pavan-inferno/AutomationProject/GUI/mattress.PNG

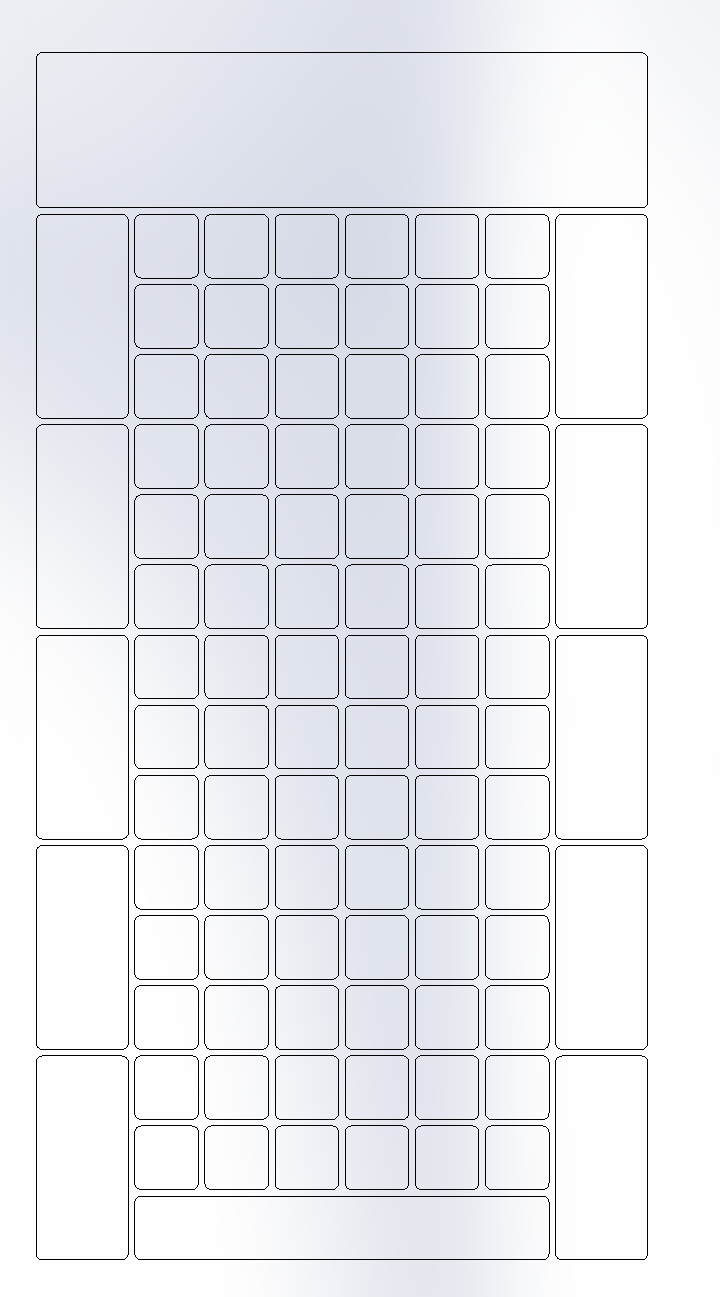
GUI/mattress.PNG
