pavan-inferno/AutomationProject/GUI/mattress_numbering.PNG

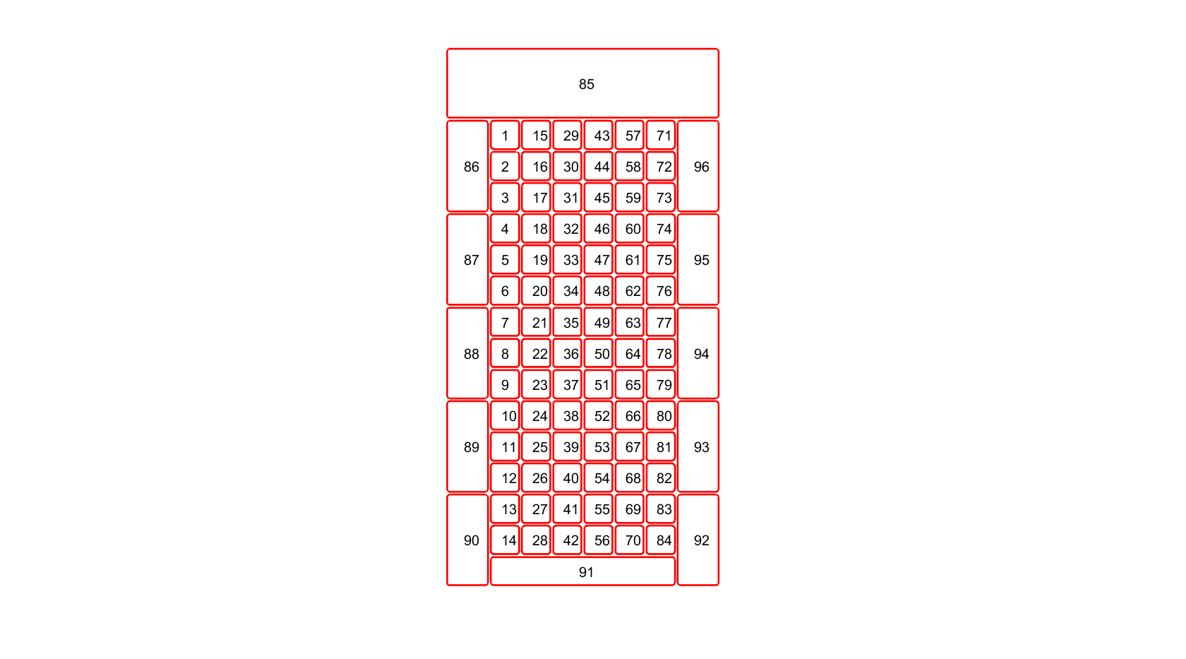
GUI/mattress_numbering.PNG
