pavan-inferno/AutomationProject/PCB/CPplacement.PNG

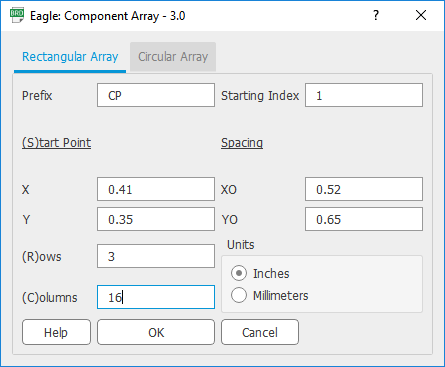
PCB/CPplacement.PNG
