pavan-inferno/AutomationProject/PCB/bed_prod.brd

## EAGLE design PCB/bed_prod.brd (2020-02-03)

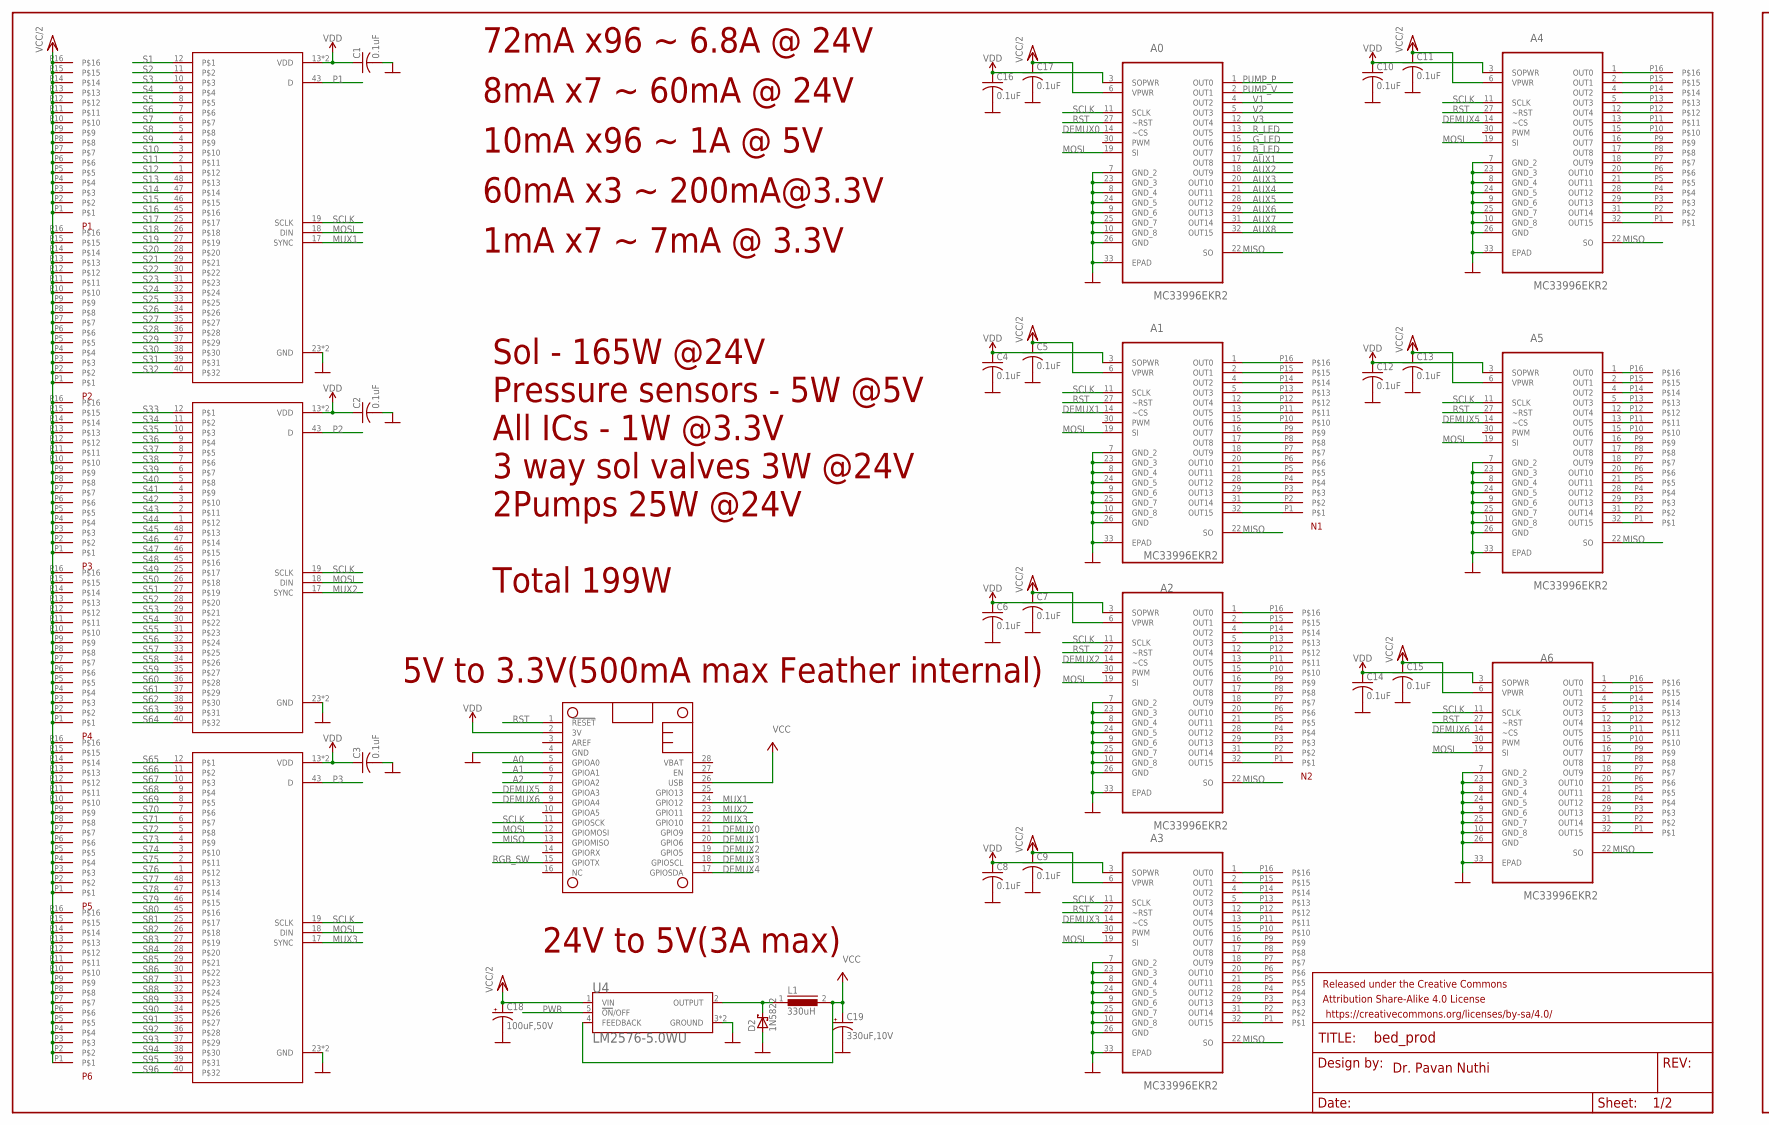
[picture p4: schematic bed_prod.sch, sheet 1, part in row 1, column 1]

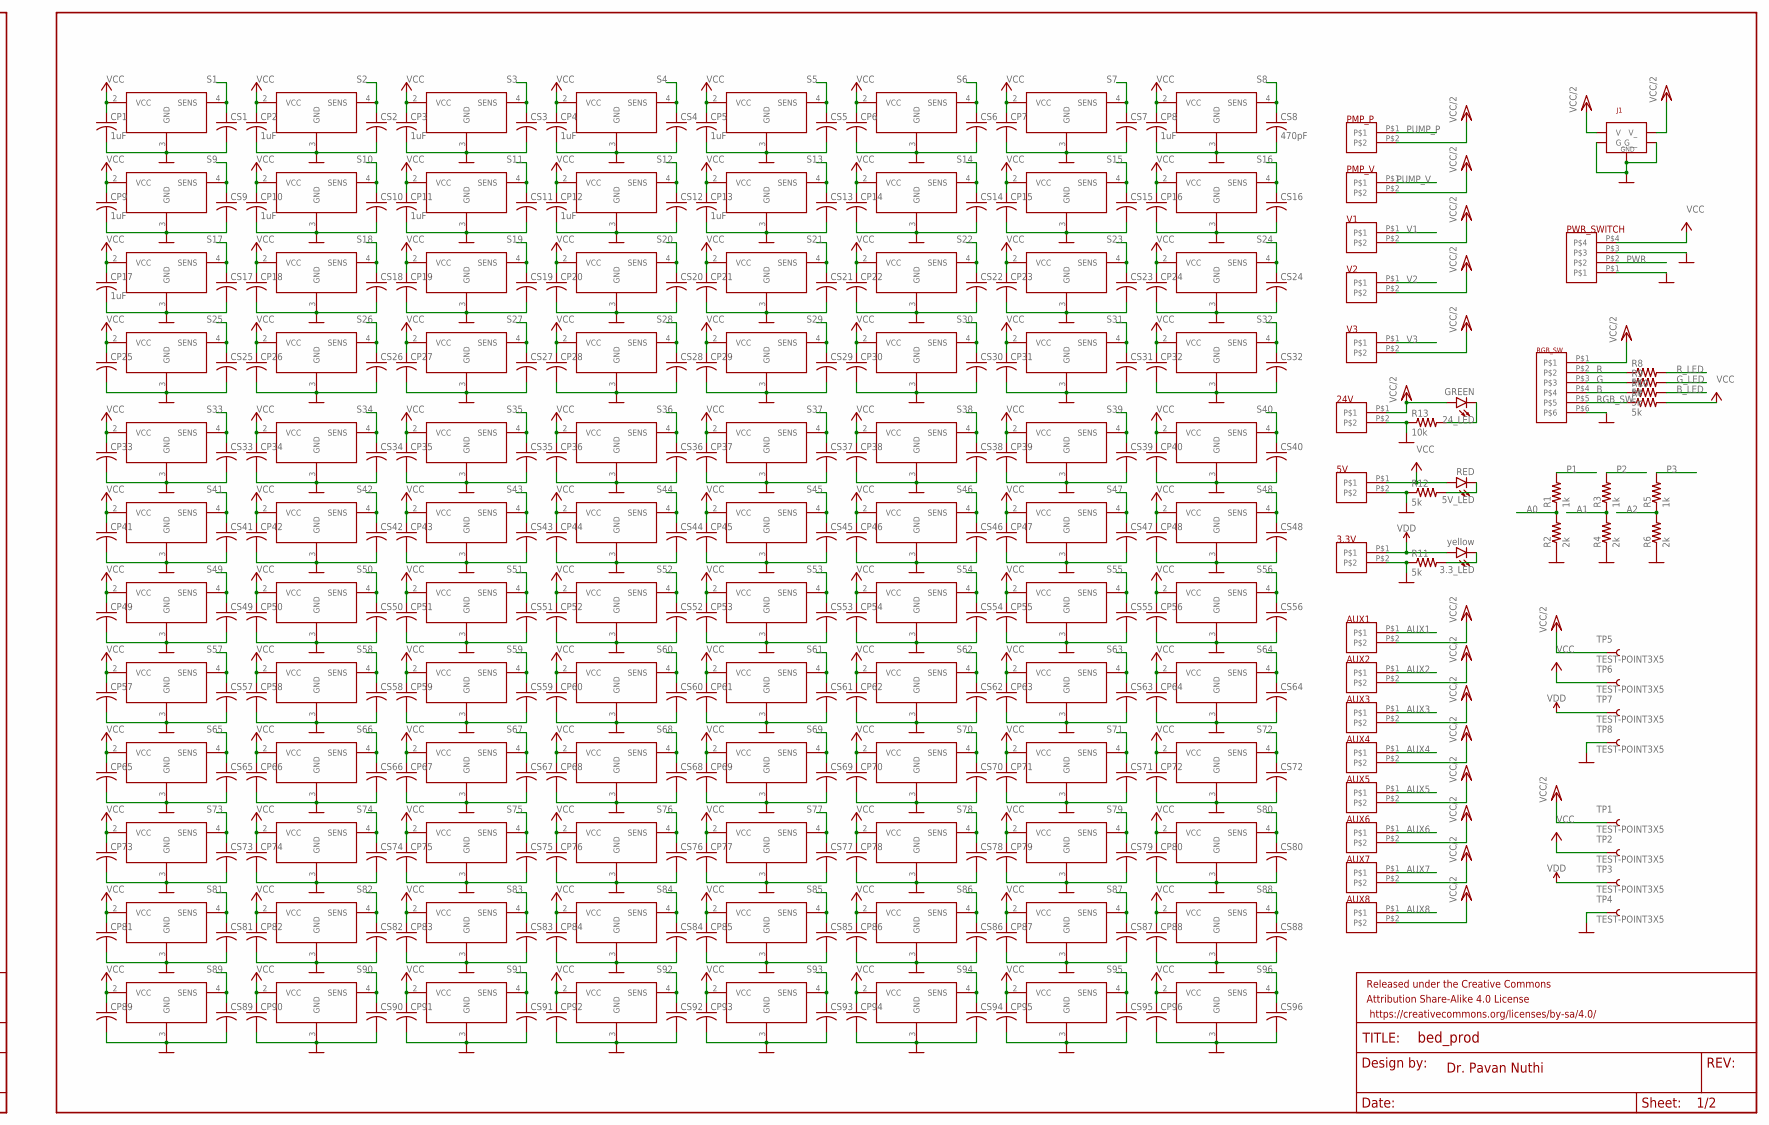
[picture p5: schematic bed_prod.sch, sheet 1, part in row 1, column 2]

Parts:
3.3V, 5V, 24V: 2CONN_2MM
3.3_LED: yellow; LED-1206
5V_LED: RED; LED-1206
24_LED: GREEN; LED-1206
A0, A1, A2, A3, A4, A5, A6: MC33996EKR2; SOIC65P1030X265-32N
AUX1, AUX2, AUX3, AUX4, AUX5, AUX6, AUX7, AUX8: 2CONN_2MM
C1, C2, C3, C4, C5, C6, C7, C8, C9, C10, C11, C12, C13, C14, C15, C16, C17: 0.1uF; C1206
C18: 100uF,50V; E3,5-8
C19: 330uF,10V; E3,5-8
CP1, CP2, CP3, CP4, CP5, CP8, CP9, CP10, CP11, CP12, CP13, CP17: 1uF; C1206
CP6, CP7, CP14, CP15, CP16, CP18, CP19, CP20, CP21, CP22, CP23, CP24, CP25, CP26, CP27, CP28, CP29, CP30, CP31, CP32, CP33, CP34, CP35, CP36, CP37, CP38, CP39, CP40, CP41, CP42, CP43, CP44, CP45, CP46, CP47, CP48, CP49, CP50, CP51, CP52, CP53, CP54, CP55, CP56, CP57, CP58, CP59, CP60, CP61, CP62, CP63, CP64, CP65, CP66, CP67, CP68, CP69, CP70, CP71, CP72, CP73, CP74, CP75, CP76, CP77, CP78, CP79, CP80, CP81, CP82, CP83, CP84, CP85, CP86, CP87, CP88, CP89, CP90, CP91, CP92, CP93, CP94, CP95, CP96: C-USC1206; C1206
CS1, CS2, CS3, CS4, CS5, CS6, CS7, CS9, CS10, CS11, CS12, CS13, CS14, CS15, CS16, CS17, CS18, CS19, CS20, CS21, CS22, CS23, CS24, CS25, CS26, CS27, CS28, CS29, CS30, CS31, CS32, CS33, CS34, CS35, CS36, CS37, CS38, CS39, CS40, CS41, CS42, CS43, CS44, CS45, CS46, CS47, CS48, CS49, CS50, CS51, CS52, CS53, CS54, CS55, CS56, CS57, CS58, CS59, CS60, CS61, CS62, CS63, CS64, CS65, CS66, CS67, CS68, CS69, CS70, CS71, CS72, CS73, CS74, CS75, CS76, CS77, CS78, CS79, CS80, CS81, CS82, CS83, CS84, CS85, CS86, CS87, CS88, CS89, CS90, CS91, CS92, CS93, CS94, CS95, CS96: C-USC1206; C1206
CS8: 470pF; C1206
D2: 1N5822; DO201T15
FRAME1, FRAME2: FRAME-LEDGER; CREATIVE_COMMONS
J1: KPJX-4S-S; KYCON-KPXJ-4S
L1: 330uH; DR127
MS1: FEATHERWING_NODIM; FEATHERWING_DIM
N1, N2, N3, N4, N5, N6: 16CONN_2MM
P1, P2, P3, P4, P5, P6: 16CONN_2MM
PMP_P: 2CONN_2MM
PMP_V: 2CONN_2MM
PWR_SWITCH: 4CONN_2MM
R1, R3, R5: 1k; R1206
R2, R4, R6: 2k; R1206
R7, R9, R10, R11, R12: 5k; R1206W
R8: 5K; R1206W
R13: 10k; R1206W
RGB_SW: 6CONN_2MM
SENS1, SENS2, SENS3, SENS4, SENS5, SENS6, SENS7, SENS8, SENS9, SENS10, SENS11, SENS12, SENS13, SENS14, SENS15, SENS16, SENS17, SENS18, SENS19, SENS20, SENS21, SENS22, SENS23, SENS24, SENS25, SENS26, SENS27, SENS28, SENS29, SENS30, SENS31, SENS32, SENS33, SENS34, SENS35, SENS36, SENS37, SENS38, SENS39, SENS40, SENS41, SENS42, SENS43, SENS44, SENS45, SENS46, SENS47, SENS48, SENS49, SENS50, SENS51, SENS52, SENS53, SENS54, SENS55, SENS56, SENS57, SENS58, SENS59, SENS60, SENS61, SENS62, SENS63, SENS64, SENS65, SENS66, SENS67, SENS68, SENS69, SENS70, SENS71, SENS72, SENS73, SENS74, SENS75, SENS76, SENS77, SENS78, SENS79, SENS80, SENS81, SENS82, SENS83, SENS84, SENS85, SENS86, SENS87, SENS88, SENS89, SENS90, SENS91, SENS92, SENS93, SENS94, SENS95, SENS96: MPX5100; 98ASB17759C
TP1, TP2, TP3, TP4, TP5, TP6, TP7, TP8: TEST-POINT3X5; PAD.03X.05
U1, U2, U3: ADG731; QFP50P900X900X160-49N
U4: LM2576-5.0WU; DPAK6P170_1524X459L254X81N
V1, V2, V3: 2CONN_2MM

Connections:
A0: MS1.5 (GPIOA0), R1.1, R2.2
A1: MS1.6 (GPIOA1), R3.1, R4.2
A2: MS1.7 (GPIOA2), R5.1, R6.2
AUX1: A0.17 (OUT8), AUX1.P$1
AUX2: A0.18 (OUT9), AUX2.P$1
AUX3: A0.20 (OUT10), AUX3.P$1
AUX4: A0.21 (OUT11), AUX4.P$1
AUX5: A0.28 (OUT12), AUX5.P$1
AUX6: A0.29 (OUT13), AUX6.P$1
AUX7: A0.31 (OUT14), AUX7.P$1
AUX8: A0.32 (OUT15), AUX8.P$1
B: R10.1, RGB_SW.P$4
B_LED: A0.16 (OUT7), R10.2
DEMUX0: A0.14 (~CS), MS1.21 (GPIO9)
DEMUX1: A1.14 (~CS), MS1.20 (GPIO6)
DEMUX2: A2.14 (~CS), MS1.19 (GPIO5)
DEMUX3: A3.14 (~CS), MS1.18 (GPIOSCL)
DEMUX4: A4.14 (~CS), MS1.17 (GPIOSDA)
DEMUX5: A5.14 (~CS), MS1.8 (GPIOA3)
DEMUX6: A6.14 (~CS), MS1.9 (GPIOA4)
G: R9.1, RGB_SW.P$3
GND: 3.3V.P$2, 5V.P$2, 24V.P$2, A0.7 (GND_2), A0.8 (GND_4), A0.9 (GND_6), A0.10 (GND_8), A0.23 (GND_3), A0.24 (GND_5), A0.25 (GND_7), A0.26 (GND), A0.33 (EPAD), A1.7 (GND_2), A1.8 (GND_4), A1.9 (GND_6), A1.10 (GND_8), A1.23 (GND_3), A1.24 (GND_5), A1.25 (GND_7), A1.26 (GND), A1.33 (EPAD), A2.7 (GND_2), A2.8 (GND_4), A2.9 (GND_6), A2.10 (GND_8), A2.23 (GND_3), A2.24 (GND_5), A2.25 (GND_7), A2.26 (GND), A2.33 (EPAD), A3.7 (GND_2), A3.8 (GND_4), A3.9 (GND_6), A3.10 (GND_8), A3.23 (GND_3), A3.24 (GND_5), A3.25 (GND_7), A3.26 (GND), A3.33 (EPAD), A4.7 (GND_2), A4.8 (GND_4), A4.9 (GND_6), A4.10 (GND_8), A4.23 (GND_3), A4.24 (GND_5), A4.25 (GND_7), A4.26 (GND), A4.33 (EPAD), A5.7 (GND_2), A5.8 (GND_4), A5.9 (GND_6), A5.10 (GND_8), A5.23 (GND_3), A5.24 (GND_5), A5.25 (GND_7), A5.26 (GND), A5.33 (EPAD), A6.7 (GND_2), A6.8 (GND_4), A6.9 (GND_6), A6.10 (GND_8), A6.23 (GND_3), A6.24 (GND_5), A6.25 (GND_7), A6.26 (GND), A6.33 (EPAD), C1.2, C2.2, C3.2, C4.2, C5.2, C6.2, C7.2, C8.2, C9.2, C10.2, C11.2, C12.2, C13.2, C14.2, C15.2, C16.2, C17.2, C18.-, C19.-, CP1.2, CP2.2, CP3.2, CP4.2, CP5.2, CP6.2, CP7.2, CP8.2, CP9.2, CP10.2, CP11.2, CP12.2, CP13.2, CP14.2, CP15.2, CP16.2, CP17.2, CP18.2, CP19.2, CP20.2, CP21.2, CP22.2, CP23.2, CP24.2, CP25.2, CP26.2, CP27.2, CP28.2, CP29.2, CP30.2, CP31.2, CP32.2, CP33.2, CP34.2, CP35.2, CP36.2, CP37.2, CP38.2, CP39.2, CP40.2, CP41.2, CP42.2, CP43.2, CP44.2, CP45.2, CP46.2, CP47.2, CP48.2, CP49.2, CP50.2, CP51.2, CP52.2, CP53.2, CP54.2, CP55.2, CP56.2, CP57.2, CP58.2, CP59.2, CP60.2, CP61.2, CP62.2, CP63.2, CP64.2, CP65.2, CP66.2, CP67.2, CP68.2, CP69.2, CP70.2, CP71.2, CP72.2, CP73.2, CP74.2, CP75.2, CP76.2, CP77.2, CP78.2, CP79.2, CP80.2, CP81.2, CP82.2, CP83.2, CP84.2, CP85.2, CP86.2, CP87.2, CP88.2, CP89.2, CP90.2, CP91.2, CP92.2, CP93.2, CP94.2, CP95.2, CP96.2, CS1.2, CS2.2, CS3.2, CS4.2, CS5.2, CS6.2, CS7.2, CS8.2, CS9.2, CS10.2, CS11.2, CS12.2, CS13.2, CS14.2, CS15.2, CS16.2, CS17.2, CS18.2, CS19.2, CS20.2, CS21.2, CS22.2, CS23.2, CS24.2, CS25.2, CS26.2, CS27.2, CS28.2, CS29.2, CS30.2, CS31.2, CS32.2, CS33.2, CS34.2, CS35.2, CS36.2, CS37.2, CS38.2, CS39.2, CS40.2, CS41.2, CS42.2, CS43.2, CS44.2, CS45.2, CS46.2, CS47.2, CS48.2, CS49.2, CS50.2, CS51.2, CS52.2, CS53.2, CS54.2, CS55.2, CS56.2, CS57.2, CS58.2, CS59.2, CS60.2, CS61.2, CS62.2, CS63.2, CS64.2, CS65.2, CS66.2, CS67.2, CS68.2, CS69.2, CS70.2, CS71.2, CS72.2, CS73.2, CS74.2, CS75.2, CS76.2, CS77.2, CS78.2, CS79.2, CS80.2, CS81.2, CS82.2, CS83.2, CS84.2, CS85.2, CS86.2, CS87.2, CS88.2, CS89.2, CS90.2, CS91.2, CS92.2, CS93.2, CS94.2, CS95.2, CS96.2, D2.A, J1.GND (G), J1.GND_ (G_), J1.GND__ (G__), MS1.4 (GND), PWR_SWITCH.P$1, PWR_SWITCH.P$3, R2.1, R4.1, R6.1, R11.1, R12.1, R13.1, RGB_SW.P$6, SENS1.3 (GND), SENS2.3 (GND), SENS3.3 (GND), SENS4.3 (GND), SENS5.3 (GND), SENS6.3 (GND), SENS7.3 (GND), SENS8.3 (GND), SENS9.3 (GND), SENS10.3 (GND), SENS11.3 (GND), SENS12.3 (GND), SENS13.3 (GND), SENS14.3 (GND), SENS15.3 (GND), SENS16.3 (GND), SENS17.3 (GND), SENS18.3 (GND), SENS19.3 (GND), SENS20.3 (GND), SENS21.3 (GND), SENS22.3 (GND), SENS23.3 (GND), SENS24.3 (GND), SENS25.3 (GND), SENS26.3 (GND), SENS27.3 (GND), SENS28.3 (GND), SENS29.3 (GND), SENS30.3 (GND), SENS31.3 (GND), SENS32.3 (GND), SENS33.3 (GND), SENS34.3 (GND), SENS35.3 (GND), SENS36.3 (GND), SENS37.3 (GND), SENS38.3 (GND), SENS39.3 (GND), SENS40.3 (GND), SENS41.3 (GND), SENS42.3 (GND), SENS43.3 (GND), SENS44.3 (GND), SENS45.3 (GND), SENS46.3 (GND), SENS47.3 (GND), SENS48.3 (GND), SENS49.3 (GND), SENS50.3 (GND), SENS51.3 (GND), SENS52.3 (GND), SENS53.3 (GND), SENS54.3 (GND), SENS55.3 (GND), SENS56.3 (GND), SENS57.3 (GND), SENS58.3 (GND), SENS59.3 (GND), SENS60.3 (GND), SENS61.3 (GND), SENS62.3 (GND), SENS63.3 (GND), SENS64.3 (GND), SENS65.3 (GND), SENS66.3 (GND), SENS67.3 (GND), SENS68.3 (GND), SENS69.3 (GND), SENS70.3 (GND), SENS71.3 (GND), SENS72.3 (GND), SENS73.3 (GND), SENS74.3 (GND), SENS75.3 (GND), SENS76.3 (GND), SENS77.3 (GND), SENS78.3 (GND), SENS79.3 (GND), SENS80.3 (GND), SENS81.3 (GND), SENS82.3 (GND), SENS83.3 (GND), SENS84.3 (GND), SENS85.3 (GND), SENS86.3 (GND), SENS87.3 (GND), SENS88.3 (GND), SENS89.3 (GND), SENS90.3 (GND), SENS91.3 (GND), SENS92.3 (GND), SENS93.3 (GND), SENS94.3 (GND), SENS95.3 (GND), SENS96.3 (GND), TP4.P$1, TP8.P$1, U1.23 (GND), U1.24 (GND), U2.23 (GND), U2.24 (GND), U3.23 (GND), U3.24 (GND), U4.3 (GROUND), U4.6 (GROUND)
G_LED: A0.15 (OUT6), R9.2
MISO: A0.22 (SO), A1.22 (SO), A2.22 (SO), A3.22 (SO), A4.22 (SO), A5.22 (SO), A6.22 (SO), MS1.13 (GPIOMISO)
MOSI: A0.19 (SI), A1.19 (SI), A2.19 (SI), A3.19 (SI), A4.19 (SI), A5.19 (SI), A6.19 (SI), MS1.12 (GPIOMOSI), U1.18 (DIN), U2.18 (DIN), U3.18 (DIN)
MUX1: MS1.24 (GPIO12), U1.17 (SYNC)
MUX2: MS1.23 (GPIO11), U2.17 (SYNC)
MUX3: MS1.22 (GPIO10), U3.17 (SYNC)
unnamed: D2.C, L1.1, U4.2 (OUTPUT)
unnamed: A5.1 (OUT0), N5.P16
unnamed: A5.2 (OUT1), N5.P15
unnamed: A5.4 (OUT2), N5.P14
unnamed: A5.5 (OUT3), N5.P13
unnamed: A5.12 (OUT4), N5.P12
unnamed: A5.13 (OUT5), N5.P11
unnamed: A5.15 (OUT6), N5.P10
unnamed: A5.16 (OUT7), N5.P9
unnamed: A5.17 (OUT8), N5.P8
unnamed: A5.18 (OUT9), N5.P7
unnamed: A5.20 (OUT10), N5.P6
unnamed: A5.21 (OUT11), N5.P5
unnamed: A5.28 (OUT12), N5.P4
unnamed: A5.29 (OUT13), N5.P3
unnamed: A5.31 (OUT14), N5.P2
unnamed: A5.32 (OUT15), N5.P1
unnamed: A6.1 (OUT0), N6.P16
unnamed: A6.2 (OUT1), N6.P15
unnamed: A6.4 (OUT2), N6.P14
unnamed: A6.5 (OUT3), N6.P13
unnamed: A6.12 (OUT4), N6.P12
unnamed: A6.13 (OUT5), N6.P11
unnamed: A6.15 (OUT6), N6.P10
unnamed: A6.16 (OUT7), N6.P9
unnamed: A6.17 (OUT8), N6.P8
unnamed: A6.18 (OUT9), N6.P7
unnamed: A6.20 (OUT10), N6.P6
unnamed: A6.21 (OUT11), N6.P5
unnamed: A6.28 (OUT12), N6.P4
unnamed: A6.29 (OUT13), N6.P3
unnamed: A6.31 (OUT14), N6.P2
unnamed: A6.32 (OUT15), N6.P1
unnamed: A4.1 (OUT0), N4.P16
unnamed: A4.2 (OUT1), N4.P15
unnamed: A4.4 (OUT2), N4.P14
unnamed: A4.5 (OUT3), N4.P13
unnamed: A4.12 (OUT4), N4.P12
unnamed: A4.13 (OUT5), N4.P11
unnamed: A4.15 (OUT6), N4.P10
unnamed: A4.16 (OUT7), N4.P9
unnamed: A4.17 (OUT8), N4.P8
unnamed: A4.18 (OUT9), N4.P7
unnamed: A4.20 (OUT10), N4.P6
unnamed: A4.21 (OUT11), N4.P5
unnamed: A4.28 (OUT12), N4.P4
unnamed: A4.29 (OUT13), N4.P3
unnamed: A4.31 (OUT14), N4.P2
unnamed: A4.32 (OUT15), N4.P1
unnamed: A3.1 (OUT0), N3.P16
unnamed: A3.2 (OUT1), N3.P15
unnamed: A3.4 (OUT2), N3.P14
unnamed: A3.5 (OUT3), N3.P13
unnamed: A3.12 (OUT4), N3.P12
unnamed: A3.13 (OUT5), N3.P11
unnamed: A3.15 (OUT6), N3.P10
unnamed: A3.16 (OUT7), N3.P9
unnamed: A3.17 (OUT8), N3.P8
unnamed: A3.18 (OUT9), N3.P7
unnamed: A3.20 (OUT10), N3.P6
unnamed: A3.21 (OUT11), N3.P5
unnamed: A3.28 (OUT12), N3.P4
unnamed: A3.29 (OUT13), N3.P3
unnamed: A3.31 (OUT14), N3.P2
unnamed: A1.1 (OUT0), N1.P16
unnamed: A1.2 (OUT1), N1.P15
unnamed: A1.4 (OUT2), N1.P14
unnamed: A1.5 (OUT3), N1.P13
unnamed: A1.12 (OUT4), N1.P12
unnamed: A1.13 (OUT5), N1.P11
unnamed: A1.15 (OUT6), N1.P10
unnamed: A1.16 (OUT7), N1.P9
unnamed: A1.17 (OUT8), N1.P8
unnamed: A1.18 (OUT9), N1.P7
unnamed: A1.20 (OUT10), N1.P6
unnamed: A1.21 (OUT11), N1.P5
unnamed: A1.28 (OUT12), N1.P4
unnamed: A1.29 (OUT13), N1.P3
unnamed: A1.31 (OUT14), N1.P2
unnamed: A1.32 (OUT15), N1.P1
unnamed: A2.1 (OUT0), N2.P16
unnamed: A2.2 (OUT1), N2.P15
unnamed: A2.4 (OUT2), N2.P14
unnamed: A2.5 (OUT3), N2.P13
unnamed: A2.12 (OUT4), N2.P12
unnamed: A2.13 (OUT5), N2.P11
unnamed: A2.15 (OUT6), N2.P10
unnamed: A2.16 (OUT7), N2.P9
unnamed: A2.17 (OUT8), N2.P8
unnamed: A2.18 (OUT9), N2.P7
unnamed: A2.20 (OUT10), N2.P6
unnamed: A2.21 (OUT11), N2.P5
unnamed: A2.28 (OUT12), N2.P4
unnamed: A2.29 (OUT13), N2.P3
unnamed: A2.31 (OUT14), N2.P2
unnamed: A2.32 (OUT15), N2.P1
unnamed: 3.3_LED.C, R11.2
unnamed: 24_LED.C, R13.2
unnamed: 5V_LED.C, R12.2
unnamed: A3.32 (OUT15), N3.P1
P1: R1.2, U1.43 (D)
P2: R3.2, U2.43 (D)
P3: R5.2, U3.43 (D)
PUMP_P: A0.1 (OUT0), PMP_P.P$1
PUMP_V: A0.2 (OUT1), PMP_V.P$1
PWR: PWR_SWITCH.P$2, U4.5 (!ON!/OFF)
R: R8.1, RGB_SW.P$2
RGB_SW: MS1.15 (GPIOTX), R7.1, RGB_SW.P$5
RST: A0.27 (~RST), A1.27 (~RST), A2.27 (~RST), A3.27 (~RST), A4.27 (~RST), A5.27 (~RST), A6.27 (~RST), MS1.1 (!RESET)
R_LED: A0.13 (OUT5), R8.2
S1: CS1.1, SENS1.4 (SENS), U1.12
S2: CS2.1, SENS2.4 (SENS), U1.11
S3: CS3.1, SENS3.4 (SENS), U1.10
S4: CS4.1, SENS4.4 (SENS), U1.9
S5: CS5.1, SENS5.4 (SENS), U1.8
S6: CS6.1, SENS6.4 (SENS), U1.7
S7: CS7.1, SENS7.4 (SENS), U1.6
S8: CS8.1, SENS8.4 (SENS), U1.5
S9: CS9.1, SENS9.4 (SENS), U1.4
S10: CS10.1, SENS10.4 (SENS), U1.3
S11: CS11.1, SENS11.4 (SENS), U1.2
S12: CS12.1, SENS12.4 (SENS), U1.1
S13: CS13.1, SENS13.4 (SENS), U1.48
S14: CS14.1, SENS14.4 (SENS), U1.47
S15: CS15.1, SENS15.4 (SENS), U1.46
S16: CS16.1, SENS16.4 (SENS), U1.45
S17: CS17.1, SENS17.4 (SENS), U1.25
S18: CS18.1, SENS18.4 (SENS), U1.26
S19: CS19.1, SENS19.4 (SENS), U1.27
S20: CS20.1, SENS20.4 (SENS), U1.28
S21: CS21.1, SENS21.4 (SENS), U1.29
S22: CS22.1, SENS22.4 (SENS), U1.30
S23: CS23.1, SENS23.4 (SENS), U1.31
S24: CS24.1, SENS24.4 (SENS), U1.32
S25: CS25.1, SENS25.4 (SENS), U1.33
S26: CS26.1, SENS26.4 (SENS), U1.34
S27: CS27.1, SENS27.4 (SENS), U1.35
S28: CS28.1, SENS28.4 (SENS), U1.36
S29: CS29.1, SENS29.4 (SENS), U1.37
S30: CS30.1, SENS30.4 (SENS), U1.38
S31: CS31.1, SENS31.4 (SENS), U1.39
S32: CS32.1, SENS32.4 (SENS), U1.40
S33: CS33.1, SENS33.4 (SENS), U2.12
S34: CS34.1, SENS34.4 (SENS), U2.11
S35: CS35.1, SENS35.4 (SENS), U2.10
S36: CS36.1, SENS36.4 (SENS), U2.9
S37: CS37.1, SENS37.4 (SENS), U2.8
S38: CS38.1, SENS38.4 (SENS), U2.7
S39: CS39.1, SENS39.4 (SENS), U2.6
S40: CS40.1, SENS40.4 (SENS), U2.5
S41: CS41.1, SENS41.4 (SENS), U2.4
S42: CS42.1, SENS42.4 (SENS), U2.3
S43: CS43.1, SENS43.4 (SENS), U2.2
S44: CS44.1, SENS44.4 (SENS), U2.1
S45: CS45.1, SENS45.4 (SENS), U2.48
S46: CS46.1, SENS46.4 (SENS), U2.47
S47: CS47.1, SENS47.4 (SENS), U2.46
S48: CS48.1, SENS48.4 (SENS), U2.45
S49: CS49.1, SENS49.4 (SENS), U2.25
S50: CS50.1, SENS50.4 (SENS), U2.26
S51: CS51.1, SENS51.4 (SENS), U2.27
S52: CS52.1, SENS52.4 (SENS), U2.28
S53: CS53.1, SENS53.4 (SENS), U2.29
S54: CS54.1, SENS54.4 (SENS), U2.30
S55: CS55.1, SENS55.4 (SENS), U2.31
S56: CS56.1, SENS56.4 (SENS), U2.32
S57: CS57.1, SENS57.4 (SENS), U2.33
S58: CS58.1, SENS58.4 (SENS), U2.34
S59: CS59.1, SENS59.4 (SENS), U2.35
S60: CS60.1, SENS60.4 (SENS), U2.36
S61: CS61.1, SENS61.4 (SENS), U2.37
S62: CS62.1, SENS62.4 (SENS), U2.38
S63: CS63.1, SENS63.4 (SENS), U2.39
S64: CS64.1, SENS64.4 (SENS), U2.40
S65: CS65.1, SENS65.4 (SENS), U3.12
S66: CS66.1, SENS66.4 (SENS), U3.11
S67: CS67.1, SENS67.4 (SENS), U3.10
S68: CS68.1, SENS68.4 (SENS), U3.9
S69: CS69.1, SENS69.4 (SENS), U3.8
S70: CS70.1, SENS70.4 (SENS), U3.7
S71: CS71.1, SENS71.4 (SENS), U3.6
S72: CS72.1, SENS72.4 (SENS), U3.5
S73: CS73.1, SENS73.4 (SENS), U3.4
S74: CS74.1, SENS74.4 (SENS), U3.3
S75: CS75.1, SENS75.4 (SENS), U3.2
S76: CS76.1, SENS76.4 (SENS), U3.1
S77: CS77.1, SENS77.4 (SENS), U3.48
S78: CS78.1, SENS78.4 (SENS), U3.47
S79: CS79.1, SENS79.4 (SENS), U3.46
S80: CS80.1, SENS80.4 (SENS), U3.45
S81: CS81.1, SENS81.4 (SENS), U3.25
S82: CS82.1, SENS82.4 (SENS), U3.26
S83: CS83.1, SENS83.4 (SENS), U3.27
S84: CS84.1, SENS84.4 (SENS), U3.28
S85: CS85.1, SENS85.4 (SENS), U3.29
S86: CS86.1, SENS86.4 (SENS), U3.30
S87: CS87.1, SENS87.4 (SENS), U3.31
S88: CS88.1, SENS88.4 (SENS), U3.32
S89: CS89.1, SENS89.4 (SENS), U3.33
S90: CS90.1, SENS90.4 (SENS), U3.34
S91: CS91.1, SENS91.4 (SENS), U3.35
S92: CS92.1, SENS92.4 (SENS), U3.36
S93: CS93.1, SENS93.4 (SENS), U3.37
S94: CS94.1, SENS94.4 (SENS), U3.38
S95: CS95.1, SENS95.4 (SENS), U3.39
S96: CS96.1, SENS96.4 (SENS), U3.40
SCLK: A0.11 (SCLK), A1.11 (SCLK), A2.11 (SCLK), A3.11 (SCLK), A4.11 (SCLK), A5.11 (SCLK), A6.11 (SCLK), MS1.11 (GPIOSCK), U1.19 (SCLK), U2.19 (SCLK), U3.19 (SCLK)
V1: A0.4 (OUT2), V1.P$1
V2: A0.5 (OUT3), V2.P$1
V3: A0.12 (OUT4), V3.P$1
VCC: 5V.P$1, 5V_LED.A, C19.+, CP1.1, CP2.1, CP3.1, CP4.1, CP5.1, CP6.1, CP7.1, CP8.1, CP9.1, CP10.1, CP11.1, CP12.1, CP13.1, CP14.1, CP15.1, CP16.1, CP17.1, CP18.1, CP19.1, CP20.1, CP21.1, CP22.1, CP23.1, CP24.1, CP25.1, CP26.1, CP27.1, CP28.1, CP29.1, CP30.1, CP31.1, CP32.1, CP33.1, CP34.1, CP35.1, CP36.1, CP37.1, CP38.1, CP39.1, CP40.1, CP41.1, CP42.1, CP43.1, CP44.1, CP45.1, CP46.1, CP47.1, CP48.1, CP49.1, CP50.1, CP51.1, CP52.1, CP53.1, CP54.1, CP55.1, CP56.1, CP57.1, CP58.1, CP59.1, CP60.1, CP61.1, CP62.1, CP63.1, CP64.1, CP65.1, CP66.1, CP67.1, CP68.1, CP69.1, CP70.1, CP71.1, CP72.1, CP73.1, CP74.1, CP75.1, CP76.1, CP77.1, CP78.1, CP79.1, CP80.1, CP81.1, CP82.1, CP83.1, CP84.1, CP85.1, CP86.1, CP87.1, CP88.1, CP89.1, CP90.1, CP91.1, CP92.1, CP93.1, CP94.1, CP95.1, CP96.1, L1.2, MS1.26 (USB), PWR_SWITCH.P$4, R7.2, SENS1.2 (VCC), SENS2.2 (VCC), SENS3.2 (VCC), SENS4.2 (VCC), SENS5.2 (VCC), SENS6.2 (VCC), SENS7.2 (VCC), SENS8.2 (VCC), SENS9.2 (VCC), SENS10.2 (VCC), SENS11.2 (VCC), SENS12.2 (VCC), SENS13.2 (VCC), SENS14.2 (VCC), SENS15.2 (VCC), SENS16.2 (VCC), SENS17.2 (VCC), SENS18.2 (VCC), SENS19.2 (VCC), SENS20.2 (VCC), SENS21.2 (VCC), SENS22.2 (VCC), SENS23.2 (VCC), SENS24.2 (VCC), SENS25.2 (VCC), SENS26.2 (VCC), SENS27.2 (VCC), SENS28.2 (VCC), SENS29.2 (VCC), SENS30.2 (VCC), SENS31.2 (VCC), SENS32.2 (VCC), SENS33.2 (VCC), SENS34.2 (VCC), SENS35.2 (VCC), SENS36.2 (VCC), SENS37.2 (VCC), SENS38.2 (VCC), SENS39.2 (VCC), SENS40.2 (VCC), SENS41.2 (VCC), SENS42.2 (VCC), SENS43.2 (VCC), SENS44.2 (VCC), SENS45.2 (VCC), SENS46.2 (VCC), SENS47.2 (VCC), SENS48.2 (VCC), SENS49.2 (VCC), SENS50.2 (VCC), SENS51.2 (VCC), SENS52.2 (VCC), SENS53.2 (VCC), SENS54.2 (VCC), SENS55.2 (VCC), SENS56.2 (VCC), SENS57.2 (VCC), SENS58.2 (VCC), SENS59.2 (VCC), SENS60.2 (VCC), SENS61.2 (VCC), SENS62.2 (VCC), SENS63.2 (VCC), SENS64.2 (VCC), SENS65.2 (VCC), SENS66.2 (VCC), SENS67.2 (VCC), SENS68.2 (VCC), SENS69.2 (VCC), SENS70.2 (VCC), SENS71.2 (VCC), SENS72.2 (VCC), SENS73.2 (VCC), SENS74.2 (VCC), SENS75.2 (VCC), SENS76.2 (VCC), SENS77.2 (VCC), SENS78.2 (VCC), SENS79.2 (VCC), SENS80.2 (VCC), SENS81.2 (VCC), SENS82.2 (VCC), SENS83.2 (VCC), SENS84.2 (VCC), SENS85.2 (VCC), SENS86.2 (VCC), SENS87.2 (VCC), SENS88.2 (VCC), SENS89.2 (VCC), SENS90.2 (VCC), SENS91.2 (VCC), SENS92.2 (VCC), SENS93.2 (VCC), SENS94.2 (VCC), SENS95.2 (VCC), SENS96.2 (VCC), TP2.P$1, TP6.P$1, U4.4 (FEEDBACK)
VCC/2: 24V.P$1, 24_LED.A, A0.6 (VPWR), A1.6 (VPWR), A2.6 (VPWR), A3.6 (VPWR), A4.6 (VPWR), A5.6 (VPWR), A6.6 (VPWR), AUX1.P$2, AUX2.P$2, AUX3.P$2, AUX4.P$2, AUX5.P$2, AUX6.P$2, AUX7.P$2, AUX8.P$2, C5.1, C7.1, C9.1, C11.1, C13.1, C15.1, C17.1, C18.+, J1.V+ (V), J1.V++ (V_), P1.P1, P1.P2, P1.P3, P1.P4, P1.P5, P1.P6, P1.P7, P1.P8, P1.P9, P1.P10, P1.P11, P1.P12, P1.P13, P1.P14, P1.P15, P1.P16, P2.P1, P2.P2, P2.P3, P2.P4, P2.P5, P2.P6, P2.P7, P2.P8, P2.P9, P2.P10, P2.P11, P2.P12, P2.P13, P2.P14, P2.P15, P2.P16, P3.P1, P3.P2, P3.P3, P3.P4, P3.P5, P3.P6, P3.P7, P3.P8, P3.P9, P3.P10, P3.P11, P3.P12, P3.P13, P3.P14, P3.P15, P3.P16, P4.P1, P4.P2, P4.P3, P4.P4, P4.P5, P4.P6, P4.P7, P4.P8, P4.P9, P4.P10, P4.P11, P4.P12, P4.P13, P4.P14, P4.P15, P4.P16, P5.P1, P5.P2, P5.P3, P5.P4, P5.P5, P5.P6, P5.P7, P5.P8, P5.P9, P5.P10, P5.P11, P5.P12, P5.P13, P5.P14, P5.P15, P5.P16, P6.P1, P6.P2, P6.P3, P6.P4, P6.P5, P6.P6, P6.P7, P6.P8, P6.P9, P6.P10, P6.P11, P6.P12, P6.P13, P6.P14, P6.P15, P6.P16, PMP_P.P$2, PMP_V.P$2, RGB_SW.P$1, TP1.P$1, TP5.P$1, U4.1 (VIN), V1.P$2, V2.P$2, V3.P$2
VDD: 3.3V.P$1, 3.3_LED.A, A0.3 (SOPWR), A1.3 (SOPWR), A2.3 (SOPWR), A3.3 (SOPWR), A4.3 (SOPWR), A5.3 (SOPWR), A6.3 (SOPWR), C1.1, C2.1, C3.1, C4.1, C6.1, C8.1, C10.1, C12.1, C14.1, C16.1, MS1.2 (3V), TP3.P$1, TP7.P$1, U1.13 (VDD), U1.14 (VDD), U2.13 (VDD), U2.14 (VDD), U3.13 (VDD), U3.14 (VDD)

Notes on the sheet:
10mA x96 ~ 1A @ 5V
60mA x3 ~ 200mA@3.3V
8mA x7 ~ 60mA @ 24V
1mA x7 ~ 7mA @ 3.3V
24V to 5V(3A max)
5V to 3.3V(500mA max Feather internal)
72mA x96 ~ 6.8A @ 24V
Sol - 165W @24V Pressure sensors - 5W @5V All ICs - 1W @3.3V 3 way sol valves 3W @24V 2Pumps 25W @24V Total 199W
Dr. Pavan Nuthi

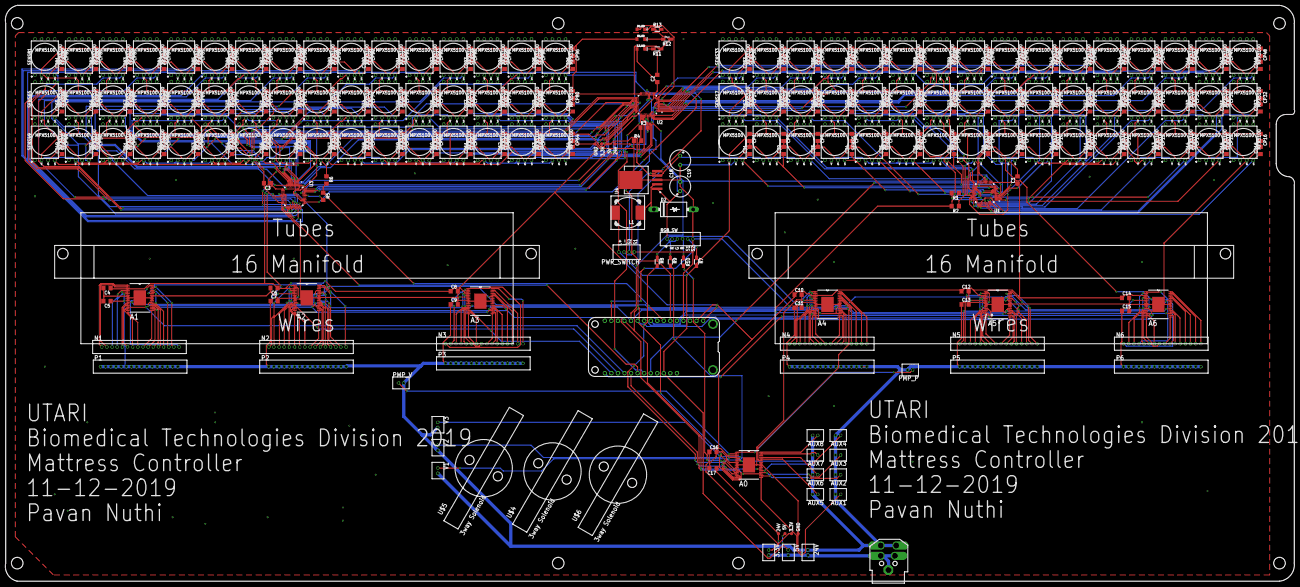
[picture p6: board bed_prod.brd from above]

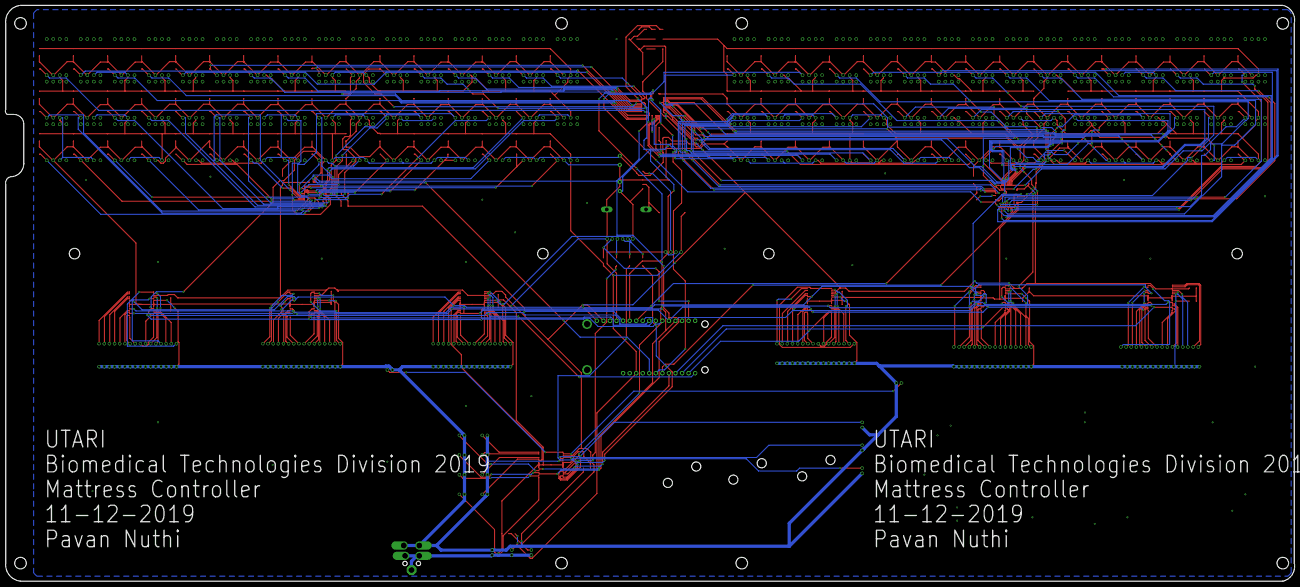
[picture p7: board bed_prod.brd from below]

Board: 2 copper layers, 500.0 x 223.3 mm, 384 parts (2 on the bottom side), 241 nets.

Other parts of the board:
U$1, U$3: MANIFOLD16
U$2: PTS-25349-C
U$4, U$5, U$6: EVO-3-24
